horca17/nv-odmr-bench/data/triada_07Oct_1724.png

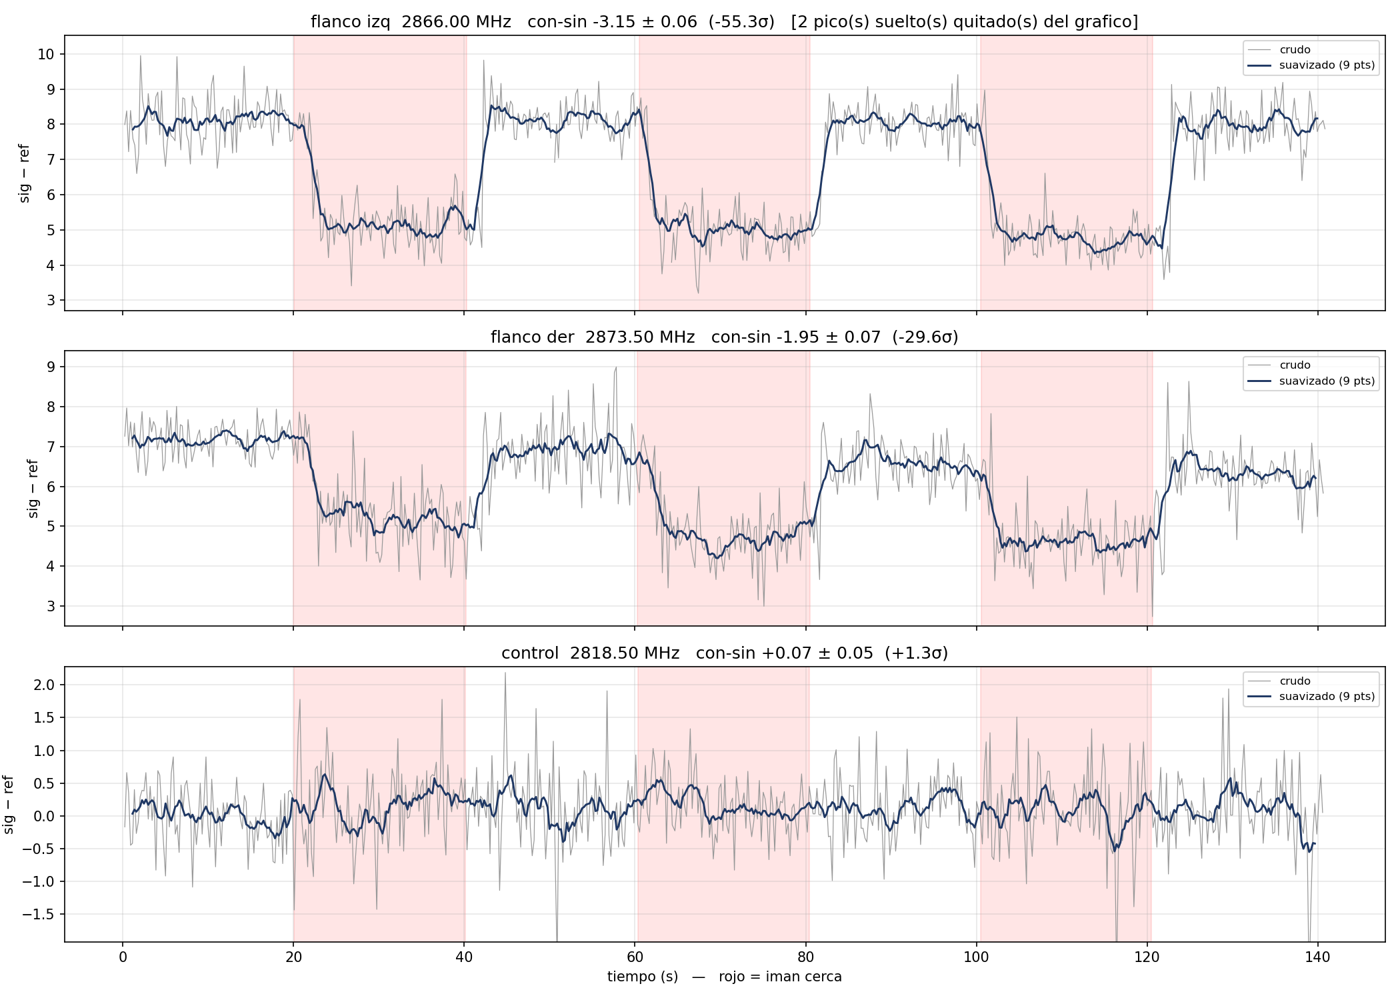
data/triada_07Oct_1724.png
