horca17/nv-odmr-bench/firmware/uncut-gem-fase1-motor-medir/sweep_array_8mhz.h

byte sweepArr[128][6][5] = {

{{5, 0x00, 0x58, 0x00, 0x05}, {4, 0x00, 0x86, 0x43, 0x24}, {3, 0x00, 0x04, 0x00, 0x03}, {2, 0x38, 0x00, 0xBE, 0x42}, {1, 0x00, 0x00, 0x80, 0xC9}, {0, 0x00, 0x5E, 0x00, 0x80}},

{{5, 0x00, 0x58, 0x00, 0x05}, {4, 0x00, 0x86, 0x43, 0x24}, {3, 0x00, 0x04, 0x00, 0x03}, {2, 0x38, 0x00, 0xBE, 0x42}, {1, 0x00, 0x00, 0x80, 0xC9}, {0, 0x00, 0x5E, 0x80, 0x38}},

{{5, 0x00, 0x58, 0x00, 0x05}, {4, 0x00, 0x86, 0x43, 0x24}, {3, 0x00, 0x04, 0x00, 0x03}, {2, 0x38, 0x00, 0xBE, 0x42}, {1, 0x00, 0x00, 0x80, 0xC9}, {0, 0x00, 0x5E, 0x80, 0xB8}},

{{5, 0x00, 0x58, 0x00, 0x05}, {4, 0x00, 0x86, 0x43, 0x24}, {3, 0x00, 0x04, 0x00, 0x03}, {2, 0x38, 0x00, 0xBE, 0x42}, {1, 0x00, 0x00, 0x80, 0xC9}, {0, 0x00, 0x5F, 0x00, 0x70}},

{{5, 0x00, 0x58, 0x00, 0x05}, {4, 0x00, 0x86, 0x43, 0x24}, {3, 0x00, 0x04, 0x00, 0x03}, {2, 0x38, 0x00, 0xBE, 0x42}, {1, 0x00, 0x00, 0x80, 0xC9}, {0, 0x00, 0x5F, 0x80, 0x28}},

{{5, 0x00, 0x58, 0x00, 0x05}, {4, 0x00, 0x86, 0x43, 0x24}, {3, 0x00, 0x04, 0x00, 0x03}, {2, 0x38, 0x00, 0xBE, 0x42}, {1, 0x00, 0x00, 0x80, 0xC9}, {0, 0x00, 0x5F, 0x80, 0xA8}},

{{5, 0x00, 0x58, 0x00, 0x05}, {4, 0x00, 0x86, 0x43, 0x24}, {3, 0x00, 0x04, 0x00, 0x03}, {2, 0x38, 0x00, 0xBE, 0x42}, {1, 0x00, 0x00, 0x80, 0xC9}, {0, 0x00, 0x60, 0x00, 0x60}},

{{5, 0x00, 0x58, 0x00, 0x05}, {4, 0x00, 0x86, 0x43, 0x24}, {3, 0x00, 0x04, 0x00, 0x03}, {2, 0x38, 0x00, 0xBE, 0x42}, {1, 0x00, 0x00, 0x80, 0xC9}, {0, 0x00, 0x60, 0x80, 0x18}},

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

{{5, 0x00, 0x58, 0x00, 0x05}, {4, 0x00, 0x86, 0x43, 0x24}, {3, 0x00, 0x04, 0x00, 0x03}, {2, 0x38, 0x00, 0xBE, 0x42}, {1, 0x00, 0x00, 0x80, 0xC9}, {0, 0x00, 0x86, 0x80, 0xB8}},
};
