horca17/nv-odmr-bench/firmware/uncut-gem-fase1-motor-medir/sweep_array_segmentado_pfd25.h

byte sweepArr[128][6][5] = {

{{5, 0x00, 0x58, 0x00, 0x05}, {4, 0x00, 0x8C, 0x83, 0x24}, {3, 0x00, 0x04, 0x00, 0x03}, {2, 0x38, 0x00, 0x7E, 0x42}, {1, 0x00, 0x00, 0x86, 0x41}, {0, 0x00, 0x39, 0x00, 0x80}},

{{5, 0x00, 0x58, 0x00, 0x05}, {4, 0x00, 0x8C, 0x83, 0x24}, {3, 0x00, 0x04, 0x00, 0x03}, {2, 0x38, 0x00, 0x7E, 0x42}, {1, 0x00, 0x00, 0x86, 0x41}, {0, 0x00, 0x39, 0x00, 0x88}},

{{5, 0x00, 0x58, 0x00, 0x05}, {4, 0x00, 0x8C, 0x83, 0x24}, {3, 0x00, 0x04, 0x00, 0x03}, {2, 0x38, 0x00, 0x7E, 0x42}, {1, 0x00, 0x00, 0x86, 0x41}, {0, 0x00, 0x39, 0x00, 0x90}},

{{5, 0x00, 0x58, 0x00, 0x05}, {4, 0x00, 0x8C, 0x83, 0x24}, {3, 0x00, 0x04, 0x00, 0x03}, {2, 0x38, 0x00, 0x7E, 0x42}, {1, 0x00, 0x00, 0x86, 0x41}, {0, 0x00, 0x39, 0x00, 0x98}},

{{5, 0x00, 0x58, 0x00, 0x05}, {4, 0x00, 0x8C, 0x83, 0x24}, {3, 0x00, 0x04, 0x00, 0x03}, {2, 0x38, 0x00, 0x7E, 0x42}, {1, 0x00, 0x00, 0x86, 0x41}, {0, 0x00, 0x39, 0x00, 0xA0}},

{{5, 0x00, 0x58, 0x00, 0x05}, {4, 0x00, 0x8C, 0x83, 0x24}, {3, 0x00, 0x04, 0x00, 0x03}, {2, 0x38, 0x00, 0x7E, 0x42}, {1, 0x00, 0x00, 0x86, 0x41}, {0, 0x00, 0x39, 0x00, 0xA8}},

{{5, 0x00, 0x58, 0x00, 0x05}, {4, 0x00, 0x8C, 0x83, 0x24}, {3, 0x00, 0x04, 0x00, 0x03}, {2, 0x38, 0x00, 0x7E, 0x42}, {1, 0x00, 0x00, 0x86, 0x41}, {0, 0x00, 0x39, 0x00, 0xB0}},

{{5, 0x00, 0x58, 0x00, 0x05}, {4, 0x00, 0x8C, 0x83, 0x24}, {3, 0x00, 0x04, 0x00, 0x03}, {2, 0x38, 0x00, 0x7E, 0x42}, {1, 0x00, 0x00, 0x86, 0x41}, {0, 0x00, 0x39, 0x00, 0xB8}},

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

{{5, 0x00, 0x58, 0x00, 0x05}, {4, 0x00, 0x8C, 0x83, 0x24}, {3, 0x00, 0x04, 0x00, 0x03}, {2, 0x38, 0x00, 0x7E, 0x42}, {1, 0x00, 0x00, 0x86, 0x41}, {0, 0x00, 0x39, 0x83, 0x70}},
};
