horca17/nv-odmr-bench/firmware/uncut-gem-fase1-motor-medir/adf4350.cpp

/*
   ADF4350.cpp - ADF4350 PLL Communication Library
   Created by Neal Pisenti, 2013.
   JQI - Strontium - UMD

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

 */

#include "Arduino.h"
#include "SPI.h"
#include "adf4350.h"
#include "sweep_array.h"



// NOTE: Currently, set up for channel spacing of 10Mhz; might ammend later if needed,
//  but this was easy and takes care of forseeable applications...
//  This means we'll be operating in int-N mode.
//
//  Currently, keep frequency between 140Mhz and 3Ghz.

/* CONSTRUCTOR */

// Constructor function; initializes communication pinouts

ADF4350::ADF4350(byte LEPin, byte ADC_pin) {
    _LEPin = LEPin;
    _ADCpin = ADC_pin;
    pinMode(_LEPin, OUTPUT);
    digitalWrite(_LEPin, HIGH);
    // setup ESP32 SPI object
    spi = new SPIClass(VSPI);
    spi->begin(SPI_SCLK, SPI_MISO, SPI_MOSI, SPI_SS);
}


// Initializes a new ADF4350 object, with refClk (in Mhz), and initial frequency.
void ADF4350::init(int freq, int refClk = 10){
    _refClk = refClk;
    _phase = 1;

    _feedbackType = 0;
    _powerdown = 0;
    _auxEnabled = 0;
    _rfEnabled = 1;

    // default power = 5dbm
    _auxPower = 3;
    _rfPower = 3;

    // sets register values which don't have dynamic values...
    ADF4350::setR1();
    ADF4350::setR3();
    ADF4350::setR5();


    ADF4350::setFreq(freq);
    // ADF4350::update();
}

// gets current frequency setting
int ADF4350::getFreq(){
    return _freq;
}

void ADF4350::setFreq(int freq){
    /*
    THIS IS BS (PROFESSIONAL ASSESSMENT) -MC
    _freq = freq;
    int multiplier;

    // selects the right divider range (ie, output divider is 2^(_divider))
    // the multiplier is required if you're using fundamental feedback to N-counter
    if (_freq <= 270 && _freq >= 140){
        _divider = 4;
        multiplier = 16;
    } else if (_freq >= 280 && _freq <= 540){
        _divider = 3;
        multiplier = 8;
    } else if (_freq >= 550 && _freq <= 1090){
        _divider = 2;
        multiplier = 4;
    } else if (_freq >= 1100 && _freq <= 2190){
        _divider = 1;
        multiplier = 2;
    } else{
        _divider = 0;
        multiplier = 1;
    }

    if (_feedbackType == 0){
        _int = _freq/_refClk;
    } else{
        _int = _freq*multiplier/_refClk;
    } */
    //ADF4350::update();
}



// updates dynamic registers, and writes values to PLL board
void ADF4350::update(){
    // updates registers with dynamic values...
    ADF4350::setR0();
    ADF4350::setR2();
    ADF4350::setR4();

    // writes registers to device
    ADF4350::writeRegister(_r5);
    ADF4350::writeRegister(_r4);
    ADF4350::writeRegister(_r3);
    ADF4350::writeRegister(_r2);
    ADF4350::writeRegister(_r1);
    ADF4350::writeRegister(_r0);
}

void ADF4350::setFeedbackType(bool feedback){
    _feedbackType = feedback;
}

void ADF4350::powerDown(bool pd){
    _powerdown = pd;
    ADF4350::setR2();
    ADF4350::update();

}

void ADF4350::rfEnable(bool rf){
    _rfEnabled = rf;
    ADF4350::setR4();
    ADF4350::update();
}

// CAREFUL!!!! pow must be 0, 1, 2, or 3... corresponding to -4, -1, 3, 5 dbm.
void ADF4350::setRfPower(int pow){
    _rfPower = pow;
    ADF4350::setR4();
    ADF4350::update();
}

void ADF4350::auxEnable(bool aux){
    _auxEnabled = aux;
    ADF4350::setR4();
    ADF4350::update();
}

// CAREFUL!!!! pow must be 0, 1, 2, or 3... corresponding to -4, -1, 3, 5 dbm.
void ADF4350::setAuxPower(int pow){
    _auxPower = pow;
    ADF4350::setR4();
    ADF4350::update();
}

// REGISTER UPDATE FUNCTIONS

void ADF4350::setR0(){
    unsigned long r0 = (_int << 15); // sets int value...
    byte r0Ary[] = { lowByte(r0 >> 24), lowByte(r0 >> 16), lowByte(r0 >> 8), lowByte(r0) };
    memcpy(&_r0, &r0Ary, sizeof(r0Ary));
}

void ADF4350::setR1(){
    unsigned long r1 =   (_phase << 15) + // phase value = 1
            (2 << 3) + // modulus value = 1
             1; // register value
    byte r1Ary[] = { lowByte(r1 >> 24), lowByte(r1 >> 16), lowByte(r1 >> 8), lowByte(r1) };
    memcpy(&_r1, &r1Ary, sizeof(r1Ary));
}

void ADF4350::setR2(){
    unsigned long r2 =   (6 << 26) +  // muxout
            (1 << 14) +  // r-counter = 1
            (7 << 9) +  // charge pump = 2.5
            (5 << 6) +  // digital lock detect + polarity
            (_powerdown << 5) +   // powerdown 0 = false; 1 = true
            2; // register value

    byte r2Ary[] =  { lowByte(r2 >> 24), lowByte(r2 >> 16), lowByte(r2 >> 8), lowByte(r2) };
    memcpy(&_r2, &r2Ary, sizeof(r2Ary));
}

void ADF4350::setR3(){
   unsigned long r3 =  3; // (all zero, except register control value = 3);
   byte r3Ary[] = { lowByte(r3 >> 24), lowByte(r3 >> 16), lowByte(r3 >> 8), lowByte(r3) };
   memcpy(&_r3, &r3Ary, sizeof(r3Ary));
}

void ADF4350::setR4(){

    unsigned long r4 = (_feedbackType << 23) + // divided/fundamental feedback
        (_divider << 20) +
        (80 << 12) + // band select clock divider
        (0 << 9) + // vco powerdown = false; MTLD = 1; aux output = divided;
        (_auxEnabled << 8) + // AUX OUTPUT enable/disable
        (_auxPower << 6) + // aux output power = {-4, -1, 2, 5dbm}
        (_rfEnabled << 5) + // RF OUTPUT ENABLED
        (_rfPower << 3) + // RF output power = 5dbm
        4;  // register select

   byte r4Ary[] = { lowByte(r4 >> 24), lowByte(r4 >> 16), lowByte(r4 >> 8), lowByte(r4) };
   memcpy(&_r4, &r4Ary, sizeof(r4Ary));


}

void ADF4350::setR5(){

  unsigned long r5 = (1 << 22) + (3<<19) + 5; // lock detect pin mode = digital lock detect
  byte r5Ary[] = { lowByte(r5 >> 24), lowByte(r5 >> 16), lowByte(r5 >> 8), lowByte(r5) };
  memcpy(&_r5, &r5Ary, sizeof(r5Ary));

}

void ADF4350::send_2870(){
  // mamually calculated
  byte dataArr[6][5] = {{5, 0x00, 0x58, 0x00, 0x05},
                        {4, 0x00, 0x86, 0x43, 0x24},
                        {3, 0x00, 0x04, 0x00, 0x03},
                        {2, 0x20, 0x00, 0xBE, 0x42},
                        {1, 0x00, 0x00, 0x80, 0x29},
                        {0, 0x00, 0x72, 0x80, 0x18}};
  for(int i = 0; i < 6; i++){
    byte tmp[4]; // this isn't necessary, it's just testing for the below. -MC
    for(int j = 0; j < 4; j++){
      tmp[j] = dataArr[i][j+1];
    }
    ADF4350::writeRegister(tmp);
  }
}


// [N4, v4.6] Wrapper público de writeRegister (privado). Permite escribir
// un registro puntual desde fuera de la clase, sin pasar por sweepArr
// global ni por send_2870/send_sweep. Usado para la validación fija en
// 1970 MHz (fase_validacionSDR en el .ino), que necesita frecuencia
// distinta a la del barrido real activo (definido por SWEEP_VARIANTE)
// sin tocar ese array global ni duplicar lógica de la clase.
void ADF4350::writeRegisterRaw(byte data[4]){
  ADF4350::writeRegister(data);
}


// Sooty's mad... so he's gonna send Soo and he's gonna...
void ADF4350::send_sweep(){
  for(int i = 0; i < 128; i++){
    for(int j = 0; j < 6; j++){
      if (sweepArr[i][j][0] == 6) {
        continue; // skip this register...
      }
      byte tmp[4];
      for(int s = 0; s < 4; s++){
        tmp[s] = sweepArr[i][j][s+1];
      }
      ADF4350::writeRegister(tmp);
    }
    // delayMicroseconds(500);
    delay(1);
    int ADC_out = ADF4350::get_avg_ADC();
    // ok now take some readings and print them to Serial
    Serial.println(ADC_out);
  }
}

int ADF4350::send_sweep_step(int i){
    for(int j = 0; j < 6; j++){
      if (sweepArr[i][j][0] == 6) {
        continue; // skip this register...
      }
      byte tmp[4];
      for(int s = 0; s < 4; s++){
        tmp[s] = sweepArr[i][j][s+1];
      }
      ADF4350::writeRegister(tmp);
    }
    // delayMicroseconds(5);
    // delayMicroseconds(500);
    delay(1);
    int ADC_out = ADF4350::get_avg_ADC();
    // Serial.println(ADC_out);
    return ADC_out;
}

int ADF4350::get_avg_ADC(){
    int output = 0;
    int count = 6;
    for(int i = 0; i < count; i++){
      int val = analogRead(_ADCpin);
      output += val;
    }
    return output / count;
}


// Writes SPI to particular register.
//      registerInfo is a 2-element array which contains [register, number of bytes]
void ADF4350::writeRegister(byte data[]){
    spi->beginTransaction(SPISettings(spiClk, MSBFIRST, SPI_MODE0));
    digitalWrite(_LEPin, LOW);
    // Writes the data
    for(int i = 0; i < 4 ; i++){
        spi->transfer(data[i]);
    }
    digitalWrite(_LEPin, HIGH);
    spi->endTransaction();
}
