horca17/nv-odmr-bench/(notices)

Notices in the files:
firmware/uncut-gem-fase1-motor-medir/adf4350.cpp:
This program is free software: you can redistribute it and/or modify
it under the terms of the GNU General Public License as published by
the Free Software Foundation, either version 3 of the License, or
(at your option) any later version.
